rFeijoo/Detector_de_Polaridade/README.md

# Detector_de_Polaridade
Circuito baseado no CI LM741, com alimentação simétrica de 12V, para identificar a polaridade de fontes de tensão.

    @ Esquemático
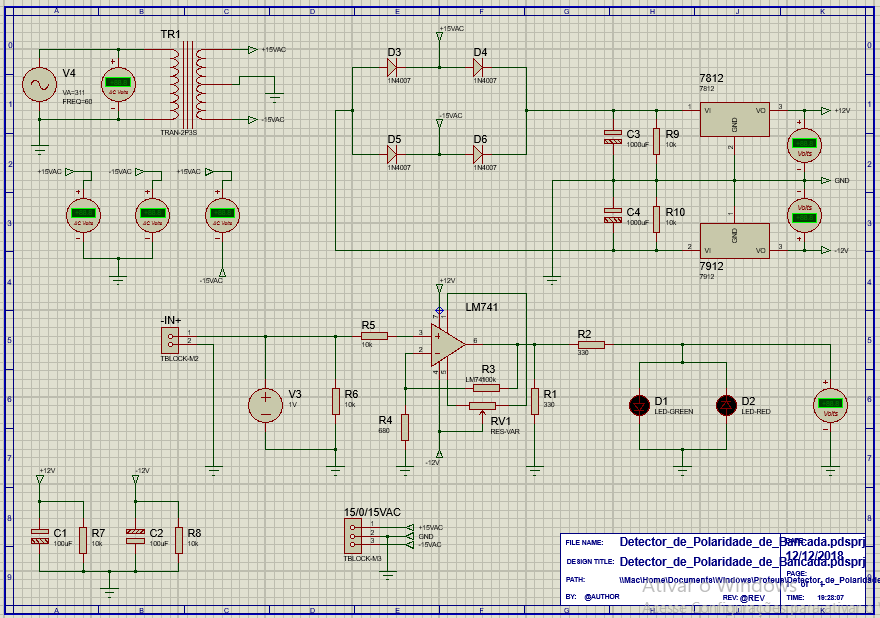
[picture p1: screenshots/esquematico.png]


    @ Layout
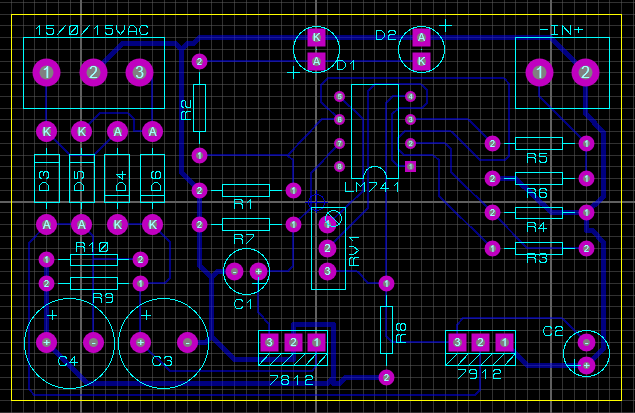
[picture p2: screenshots/layout.png]


    @ Visão 3D
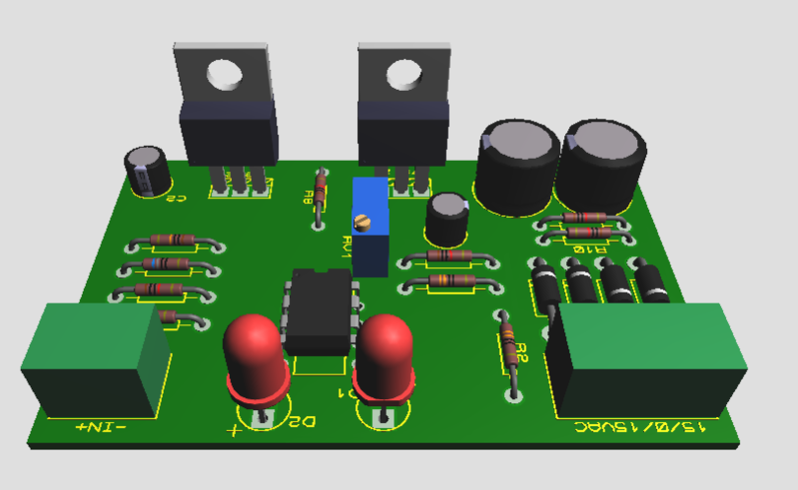
[picture p3: screenshots/3D.png]
