rFeijoo/Detector_de_Polaridade/screenshots/3D - Superior.png

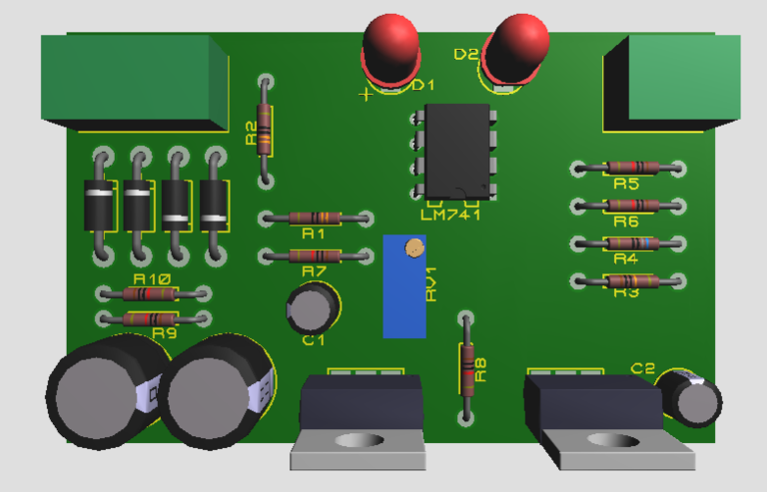
screenshots/3D - Superior.png
