rFeijoo/Detector_de_Polaridade/(list of files, drawings)

Other design files:
Detector_de_Polaridade_Simulacao.pdsprj
